Hurricos/insight_fw_RE/bootmode/Hardware/h8_ztat_flasher.kicad_sch

## KiCad design bootmode/Hardware/h8_ztat_flasher.kicad_sch (2024-08-23)

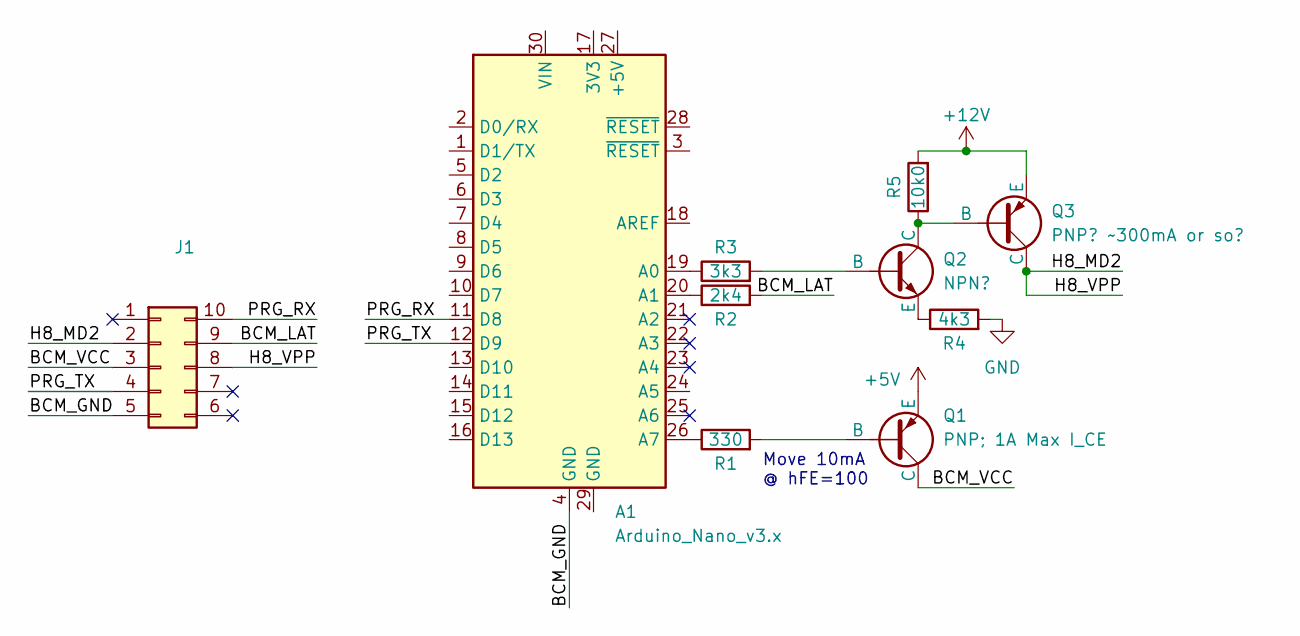
[picture p1: schematic h8_ztat_flasher.kicad_sch]

Parts:
A1: Arduino_Nano_v3.x; Arduino_Nano
J1: Conn_02x05_Counter_Clockwise
Q1: PNP; 1A Max I_CE
Q2: NPN?
Q3: PNP? ~300mA or so?
R1: 330
R2: 2k4
R3: 3k3
R4: 4k3
R5: 10k0

Connections:
+5V: Q1.3 (E)
+12V: Q3.3 (E), R5.2
BCM_GND: A1.4 (GND), J1.5
BCM_LAT: J1.9, R2.2
BCM_VCC: J1.3, Q1.1 (C)
GND: R4.2
H8_MD2: J1.2, J1.8, Q3.1 (C)
unnamed: A1.19 (A0), R3.1
unnamed: A1.20 (A1), R2.1
unnamed: A1.26 (A7), R1.1
unnamed: Q1.2 (B), R1.2
unnamed: Q2.1 (C), Q3.2 (B), R5.1
unnamed: Q2.2 (B), R3.2
unnamed: Q2.3 (E), R4.1
PRG_RX: A1.11 (D8), J1.10
PRG_TX: A1.12 (D9), J1.4

Notes on the sheet:
Move 10mA @ hFE=100
