Hurricos/insight_fw_RE/(threads)

Thread 1 (2024-06-19):

H8 boot-mode flashing protocol

Hurricos, 2024-06-19:
## Commands
4-byte command frames proposed for interacting with https://github.com/Hurricos/insight_fw_RE/blob/inwork/bootmode/h8500-boot.S:

- b[0:1][15:0]: target argument based on command
  - (S): target address
  - (P): nil
  - (R): nil
  - (W): target address word content
  - (C): length of address range. Number includes the final byte. BE, obviously, so e.g. 0x01 0x00 is 256 bytes, whereas 0x00 0x00 "does nothing".

- b2[7:0]: command
  - 0: (X) no-op for resetting command stream. If H8 target misses a byte and becomes unaligned, you can send up to QTY4 of these one at a a time and wait for a bad checksum.
  - 1: (S) seek to address, obligatorily word-aligned
  - 2: (P) show current address
  - 3: (R) peek word at current address
  - 4: (W) poke and verify word at current address and advance one word
  - 5: (C) read checksum over address range

- b[3][7:0]: frame checksum. If checksum would have been 0x00, send 0x01.

## Response format
.. Always ends with a one-byte checksum.

For X, W: format is two-bytes total:
- b0 is 0b00000000 if OK, 0b01010101 if RX checksum error, 0b11111111 if Not OK.
- b1 is response frame checksum.

For R: format is three-bytes total:
- b0 is MSB content, b1 is LSB word content.
- b2 is frame checksum.

For C: format is three-bytes total:
- b0 and b1 are MSB and LSB of two-byte additive checksum of memory range, respectively.
- b2 is frame checksum.

For P: format is three-bytes total:
- b0 and b1 are MSB and LSB of current address, respectively.
- b2 is frame checksum.

For S: format is three-bytes total:
- b0 and b1 are MSB and LSB of moved-to address, respectively.
- b2 is frame checksum.
- S is handled more carefully, as seeking to the wrong address and tripping over an unintentionally-correct checksum is not something we can ever afford.

Thread 2 (2024-08-09):

[WIP] H8 boot-mode flashing programmer

Hurricos, 2024-08-09:
- Designed around an Arduino Nano
- AltSoftSerial - Baud rate among 2400, 4800, 9600 required - see https://www.pjrc.com/teensy/td_libs_AltSoftSerial.html
- Need to be able to control voltage on three pins:
  - VPP
  - VCC
  - (blip a power supply pin to ground with a short)

### TODOs
- [ ] Find the Arduino sketch used last year for this.

Thread 3 (2024-08-09):

Rewrite Insight MCM

Hurricos, 2024-08-09:
### TODOs
- [ ] Programmer module software
  - #2.
  - Manipulates MD0/MD1/MD2/reset/VPP/VCC pins as needed to put the chip into Boot Mode.
- [ ] Programmer module hardware
  - informed by #2.
- [ ] H8 boot-mode firmware
  - #1.
- [ ] Host-side program
  - Very simple: most of the work is done by firmware in #2.
  - Prototype in .sh.
