Hurricos/insight_fw_RE/(commit log)

2023-05-17 doc: Exception vector table is made of addresses, not instructions
    Despite my initial commentary on InsightCentral[^1][^2], the exception
    vector table[^3] (Table 4-3, page 88 in H8_538F_HWM_linear.PDF) is
    made up of addresses, not instructions[^4] (5.4.2 in the PDF).
    The disassembly for this region H'0000 -> H'00FF will need to be
    rephrased.
    [^1]:
    https://www.insightcentral.net/threads/dumping-reverse-engineering-insight-g1-bcm-and-mcm-firmare.130914/post-1523805
    [^2]:
    https://www.insightcentral.net/threads/dumping-reverse-engineering-insight-g1-bcm-and-mcm-firmare.130914/page-3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
    [^3]:
    https://downloads.laboratoryb.org/insight/documents/H8_538F_HWM_linear.PDF#page=88
    [^4]:
    h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
2023-05-17 doc: SCI1 receive exception handler
    Why is the battery module preparing to receive ANYTHING? Maybe nothing
    is actually expectd on SCI1, and this is just a boilerplate handler.
2023-05-17 doc,fix: Multiple SCI handlers: rx-interrupt (RI) vs ERI (rx error)
    I needed to delineate between these two.
    Also, add reference to Exception vector table on page 107 of the
    HWM, so we can easily reference each interrupt source.
2024-01-16 feat: MCM bin and DASM
    This is from an MCM H8 silkscreened 'M56'.
2024-03-27 feat: boot-mode: pin SCI1 to 4800 baud, and document it
    We select 4800 baud pretty arbitrarily, it's just what I remember
    setting my scripts to when initially getting the program into boot
    mode. We're in async mode as we don't have an external clock to align
    serial timing.
    This commit will also help you understand how to change the baud rate
    later.
    Walking through the documentation:
    Table 12-3 of the HWM here[^1] tells us that for n=0, N=64 and
    ø=10MHz, we'd get a bit-rate of 4800 baud with +0.16% error.
    The definitions of n, N and ø are given in a legend right below those
    tables here[^2].
    - n is CKS1 * 2 + CKS0[^3]
    - N is the value of the BRR[^4] taken as a uint8
    - ø is the CPU cl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
2024-03-27 fix: boot: Preprocess (discard) semicolon comments, since old as can't
    Before this commit, `make h8500-boot.o` would fail if we had semicolon
    comments.
    That's annoying. Most assembly editors want to use ; for comments.
    So, pre-process by deleting anything after a semicolon on any line
    before assembling.
2024-05-05 bootmode: arduino: Add flashing circuit code
    This commit adds a bit of .ino used for flashing the H8/538F
    boards in the G1 Honda Insight -- both the MCM and BCM.
    Exact wiring is TBA.
2024-05-05 Add a method to reset PL2303 serial devices
2024-08-12 feat: basic h8 f-ztat flasher circuit diagram
    [h8_ztat_flasher.kicad_sch]
2024-08-12 cleanup: ztat_flasher: bin stray resistor
    [h8_ztat_flasher.kicad_sch]
2024-08-12 cleanup: h8_ztat_flasher: VPP control pin is now A0
2024-08-12 cleanup: flasher: rearrange tree
    ...
    [h8_ztat_flasher.kicad_sch]
2024-08-21 doc: Add design of flasher frame and response format
2024-08-23 doc: flasher: Diagram frame format
2024-08-23 feat: flasher: Define R1 to 330 ohms
    I need to make sure the 5V rail going to the VCC input of the TA8901SN
    combination watchdog and regulator can actually be supplied enough
    current.
    Back here[^1], I was unable to bring up the VCC pin of the
    board. Turns out, by using a 2.7k resistor on the base of the Rohm
    B1187 PNP (with a gain value between 60 and 320), I was limiting the
    current passed by the transistor and preventing the voltage regulator
    from stabilizing.
    The math from that post works out, too -- a V_B of 4.1V (compared to
    the Arduino output pin) meant that through the 2.7K resistor, only
    1.5mA could flow; at hFE=320 (the top of our range), that's at most
    480mA of current out to VCC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
    [h8_ztat_flasher.kicad_sch]
